speleoalex/fluxylogger/example_logs/log_MonteGrosso_Balbiseolo_Sciusciotto_2026/Tracciamento.md

## Tracciamento Buranco di Monte Grosso - Balbiseolo

- sabato 1 agosto 2026 Immesse 3 bombolette di aria compressa + 1 di butano a Buranco di monte grosso.
- Sensori posizionati a Balbiseolo.
- Ritiro sensori mercoledì 5 agosto
- risultato negativo su tutti i sensori

## Tracciamento Buranco di Monte Grosso - Buco Del Susciotto - Buranco dell'acquetta

- Sabato 8 agosto immesse 3 bombolette butano puro (1170 g)
- Sensori posizionati a Sciusciotto a circa 2 metri di profondità nel primo pozzoetto, un telo copriva l'ingresso ma consentiva il passaggio dell'aria.

## Buco Del Susciotto

- Monte Grosso (Q 1141 - 40 ) Sciusciotto (Q 1200 -37 ) distanza 200mt in linea d'aria con dislivello 60mt

- Primo passaggio 22:00 dopo  7 ore , picco 4:30,  13 ore e mezza dal tracciamento.
- Al momento del ritiro dei sensori c'era ancora passaggio di tracciante.

## Buranco dell'acquetta

- Sensori posizionati a circa 2 metri dall'ingresso e ritirati alle 16:30 del 9 agosto 2026. 
- Risultato negativo
