speleoalex/fluxylogger/Progetto_Fluxylogger_NASO.md

# Progetto Fluxylogger NASO (Novel Areal Sensing Observer)

Il progetto è stato avviato nel 2020 per consentire il tracciamento dei flussi d'aria all'interno delle grotte in modo semplice, economico e accessibile a tutti.

In passato, per eseguire il tracciamento dell'aria, si utilizzava la CO2 mediante estintori esauriti. Tuttavia, questo sistema risultava scomodo a causa dell'ingombro delle bombole e del rischio di falsi positivi dovuti alla respirazione. Inoltre, i datalogger per CO2 hanno un costo elevato e non sono progettati per l'utilizzo in grotta.

Il tracciante viene immesso nell'aria e il NASO ne registra la concentrazione nel tempo all'interno di una scheda SD.

Con il NASO è possibile utilizzare come traccianti il butano o il propano contenuti nelle bombolette spray di deodoranti o aria compressa per pulire le tastiere. Il progetto NASO è stato reso open source per permettere a chiunque di contribuire al suo miglioramento.

- Nel 2020 è stato sperimentato per la prima volta durante il corso di tracciamenti a Bossea nella grotta Turbiglie, affiancandolo ad altri datalogger e sensori già sperimentati. La sperimentazione ha avuto esito positivo ed il progetto è stato portato avanti.

- il 23 Agosto 2021 il progetto è stato pubblicato su GitHub all'indirizzo https://github.com/speleoalex/fluxylogger

- Tra il 2021 e il 2022, i tracciamenti tramite NASO e l'immissione di deodorante per ambienti hanno portato alla scoperta di un collegamento di un buco aspirante "Terre di sotto" con la "Grotta Priamara". È stato inoltre accertato il collegamento tra la grotta Inghiottitoio di Pian della Noce e la Priamara stessa. Sono stati effettuati altri test nella grotta Pollera e Buranco di Bardineto.

- Nel settembre 2023, il NASO è stato oggetto di discussione durante il corso sulla “Circolazione dell’aria nelle cavità carsiche: misure, monitoraggi e test con traccianti aeriformi” a Bossea il 16 e 17 settembre.

- Nel novembre 2023, è stato presentato al "Costacciaro 2023 – Raduno Internazionale di Speleologia", dopodiché è stato costruito da vari gruppi ed è in fase di sperimentazione.

- Durante il 2024 sono stati effettuati miglioramenti al datalogger ed è stata acquisita esperienza utilizzando diversi sensori e traccianti, ottimizzando il consumo delle batterie e migliorando i software di acquisizione. Altri speleologi hanno contribuito al miglioramento del software di acquisizione dei dati.

- Nel novembre 2024, all'Incontro Internazionale di Speleologia Syphonia2024, si è tenuto un incontro per fare il punto sui risultati ottenuti insieme ai gruppi che lo hanno sperimentato.

- Nel 2024 è stato creato un assistente virtuale basato su intelligenza artificiale che analizza i file di log e dà aiuti sulla costruzione del datalogger (https://www.sparkilla.com/application/NASO4CAVE)
