speleoalex/fluxylogger/doc/components.md

# Assembled version:

Assembled version available here: https://www.sparkilla.com/ecommerce_fluxylogger/

# Components required for assembly:

- ArduinoUNO
https://www.amazon.it/gp/product/B074SB6PBW/ref=ppx_yo_dt_b_asin_title_o03_s00?ie=UTF8&psc=1
- Data Logger Shield with RTC
https://www.amazon.it/gp/product/B07TZJYV1R/ref=ppx_yo_dt_b_asin_title_o04_s00?ie=UTF8&psc=1
- MQ-2 sensor (GPL, butane, hydrogen, gas, Smoke)
https://www.amazon.it/gp/product/B07V9XNCGJ/ref=ppx_yo_dt_b_asin_title_o09_s00?ie=UTF8&th=1
- Connecting wires:
https://www.amazon.it/Aukru-maschio-femmina-Arduino-Raspberry/dp/B00MWMEIF2/
- SDCard:
https://www.amazon.it/Kingston-SDCS2-32GB-microSD-Adattatore/dp/B07YGZ7FY7/
- PowerBank:
https://www.amazon.it/EnergyCell-5000mAh-Mini-Caricatore-Portatile-Samsung-Nero/dp/B09B3XSFLC/

# Kit version:

Kit available here: https://www.sparkilla.com/ecommerce_fluxylogger/

# Optional:

- Temperature, pressure, humidity.
https://www.amazon.it/gp/product/B07NYXVVXQ/ref=ppx_yo_dt_b_asin_title_o00_s00

- Wind sensor:
https://moderndevice.com/product/wind-sensor/

- SGP40 VOC sensor
https://www.amazon.it/Volatile-Compounds-Supports-Raspberry-Treatment/dp/B09D43WDVK/
