speleoalex/fluxylogger/example_logs/log_MonteGrosso_Balbiseolo_Sciusciotto_2026/Montegrosso-Sciusciotto/sciusciotto_opsa_calibrato.csv

date Y-m-d m:s | gas adc | LPG PPM | Theoretical Warmup | Warmup End | Curve: Power-law (9)
2026-08-08 12:31:12 | 218.33 | 17.741742077470786 | 218
2026-08-08 12:31:42 | 210.88 | 17.62819466155868 | 217.6974192643182
2026-08-08 12:32:12 | 207.27 | 17.62819466155868 | 217.39581883869062
2026-08-08 12:32:42 | 208.97 | 17.62819466155868 | 217.0951963808813
2026-08-08 12:33:12 | 209.28 | 17.62819466155868 | 216.79554955225478
2026-08-08 12:33:42 | 209.66 | 17.62819466155868 | 216.496876017774 |  | 209.66
2026-08-08 12:34:12 | 204.97 | 17.62819466155868 | 216.19917344599753
2026-08-08 12:34:42 | 200.16 | 17.62819466155868 | 215.90243950907717
2026-08-08 12:35:12 | 195.58 | 17.62819466155868 | 215.60667188275562
2026-08-08 12:35:42 | 196 | 17.62819466155868 | 215.31186824636399
2026-08-08 12:36:12 | 197.58 | 17.62819466155868 | 215.0180262828191
2026-08-08 12:36:42 | 195.69 | 17.62819466155868 | 214.7251436786214
2026-08-08 12:37:12 | 194.13 | 17.62819466155868 | 214.4332181238521
2026-08-08 12:37:42 | 193.42 | 17.62819466155868 | 214.14224731217112
2026-08-08 12:38:12 | 195.72 | 17.62819466155868 | 213.85222894081426
2026-08-08 12:38:42 | 198.75 | 17.62819466155868 | 213.56316071059084
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
