speleoalex/fluxylogger/example_logs/log_MonteGrosso_Balbiseolo_Sciusciotto_2026/Montegrosso-Sciusciotto/synero_opsa_calibrato.csv

date Y-m-d m:s | gas adc | LPG PPM | Theoretical Warmup | Warmup End | Curve: Power-law (9)
2026-08-08 12:31:10 | 62 | 17.62819466155868 | 62
2026-08-08 12:31:40 | 62 | 17.64433409947133 | 61.97955535569717
2026-08-08 12:32:10 | 62.27 | 17.874572932157307 | 61.95917694856018
2026-08-08 12:32:40 | 63.02 | 18.494515071000745 | 61.93886462032982
2026-08-08 12:33:10 | 64.68 | 19.89351331414711 | 61.91861821299019
2026-08-08 12:33:40 | 64.11 | 19.428611554586308 | 61.898437568768514 |  | 64.11
2026-08-08 12:34:10 | 62.97 | 18.503092062205578 | 61.878322530134966
2026-08-08 12:34:40 | 62 | 17.74026883907718 | 61.85827293980251
2026-08-08 12:35:10 | 62 | 17.756108002995536 | 61.83828864072673
2026-08-08 12:35:40 | 62 | 17.771904424897823 | 61.81836947610567
2026-08-08 12:36:10 | 61.91 | 17.71631631445643 | 61.798515289379665
2026-08-08 12:36:40 | 61.79 | 17.637093504140253 | 61.778725924231175
2026-08-08 12:37:11 | 62 | 17.81903763570037 | 61.7590012245846
2026-08-08 12:37:41 | 63.22 | 18.821326015604537 | 61.739341034606156
2026-08-08 12:38:11 | 64.08 | 19.55365252051836 | 61.71974519870366
2026-08-08 12:38:41 | 64.58 | 19.994543359062536 | 61.70021356152641
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
