speleoalex/fluxylogger/example_logs/log_MonteGrosso_Balbiseolo_Sciusciotto_2026/Montegrosso-Sciusciotto/tmgrigio_opsa_calibrato.csv

date Y-m-d m:s | gas adc | LPG PPM | Theoretical Warmup | Warmup End | Curve: Power-law (9)
2026-08-08 12:37:17 | 72 | 17.62819466155868 | 75
2026-08-08 12:37:47 | 70.87 | 17.62819466155868 | 74.8891457023139
2026-08-08 12:38:17 | 69.18 | 17.62819466155868 | 74.77871480974805
2026-08-08 12:38:47 | 69.22 | 17.62819466155868 | 74.66870612949306
2026-08-08 12:39:17 | 70.80 | 17.62819466155868 | 74.5591184709019
2026-08-08 12:39:47 | 69.20 | 17.62819466155868 | 74.4499506454882 |  | 69.20
2026-08-08 12:40:17 | 67.43 | 17.62819466155868 | 74.34120146692453
2026-08-08 12:40:47 | 66.18 | 17.62819466155868 | 74.23286975104065
2026-08-08 12:41:17 | 65.06 | 17.62819466155868 | 74.12495431582171
2026-08-08 12:41:47 | 64.19 | 17.62819466155868 | 74.0174539814066
2026-08-08 12:42:17 | 63.97 | 17.62819466155868 | 73.91036757008611
2026-08-08 12:42:47 | 63.13 | 17.62819466155868 | 73.80369390630119
2026-08-08 12:43:17 | 63.02 | 17.62819466155868 | 73.69743181664134
2026-08-08 12:43:47 | 65.11 | 17.62819466155868 | 73.59158012984265
2026-08-08 12:44:17 | 67.36 | 17.62819466155868 | 73.48613767678624
2026-08-08 12:44:47 | 68.76 | 17.62819466155868 | 73.3811032904964
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
