speleoalex/fluxylogger/example_logs/log_MonteGrosso_Balbiseolo_Sciusciotto_2026/sciusciotto_opsa_calibrato.png

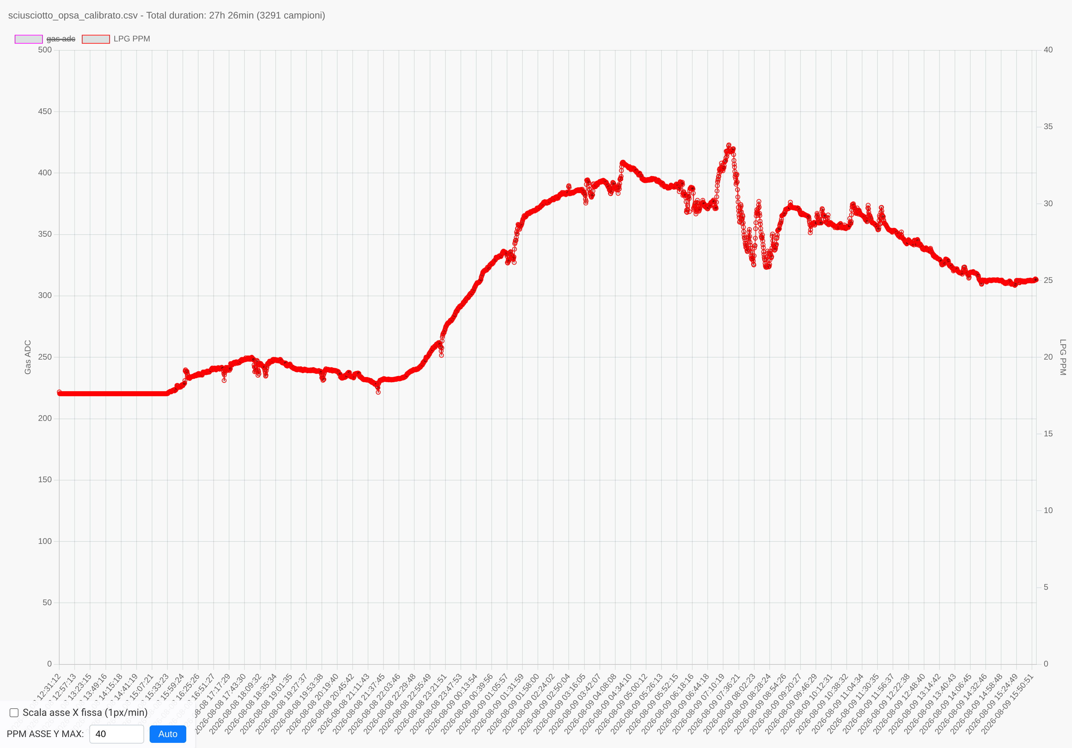
example_logs/log_MonteGrosso_Balbiseolo_Sciusciotto_2026/sciusciotto_opsa_calibrato.png
