speleoalex/fluxylogger/(commit log)

2025-12-16 Fix setconfig command not writing CONFIG.INI to SD card
    - Use O_WRITE | O_CREAT | O_TRUNC instead of FILE_WRITE to ensure
    file overwrite instead of append mode with SdFat library
    - Add explicit check for SD.remove() success before creating new file
    - Add settingFile.sync() to force physical write to SD card
    - Add debug messages showing saved values and specific error messages
    - Bump version to 2.46
    [FluxyLogger.ino]
2026-09-03 chore: add .gitattributes for GitHub Linguist language detection
    Mark the Arduino/C++ firmware as the detectable source and exclude web
    viewers, documentation, example data and IDE metadata, so GitHub reports
    the project as C++ instead of HTML.
2026-09-11 log Balbiseolo
    [sciusciotto_opsa_calibrato.csv, synero_opsa_calibrato.csv, tmgrigio_opsa_calibrato.csv]
2026-10-06 feat(firmware): v2.47 - reduce flash usage on ATmega328P
    Flash usage on Arduino UNO R3 drops from 30910 bytes (95%) to
    29388 bytes (91%); RAM from 1602 to 1550 bytes.
    Changes to reduce flash occupation:
    1) CHECK_FLASH_PROGRAMMING set to 0 (was 1).
    2) Removed sprintf() from DL_strNow(), DL_strDateToFilename() and
    DL_openLogFile(), replaced by two small helpers (put2/put4year)
    that write the digits directly. printf is no longer linked,
    saving ~1.5 KB. The date/time string formats are unchanged:
    strDate -> "2026-08-03 12:52:35"
    strFileDate -> "2026-08-03_12.52.35.txt"
    DL_openLogFile() now uses strcpy() instead of passing the file
    name as a sprintf format string.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
    [FluxyLogger.ino]
